gubin210518-alt/busrk-2026-demoday/docs/photos/prototype.jpg

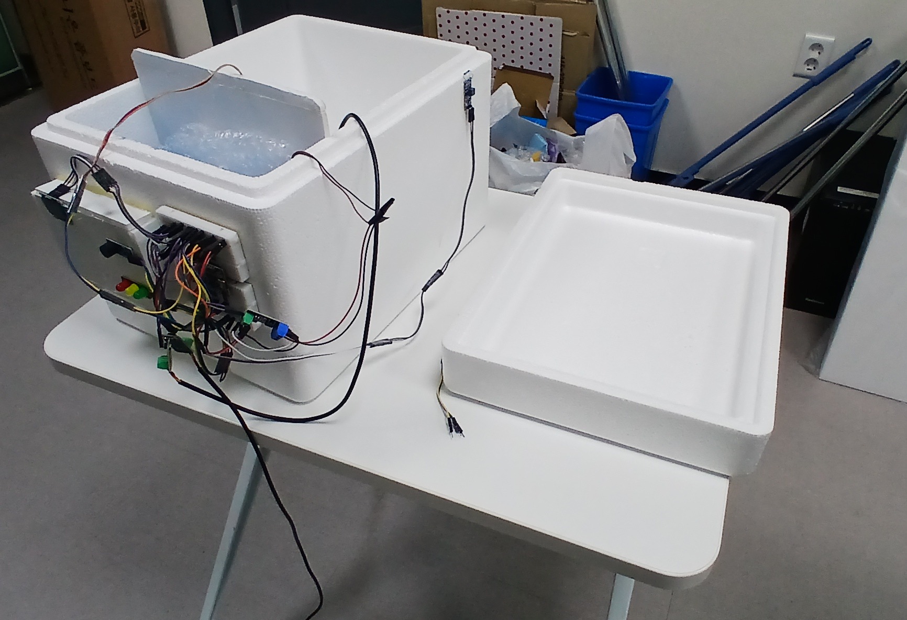
docs/photos/prototype.jpg
