gubin210518-alt/busrk-2026-demoday/README.md

# 부스럭 · 식품의 골든타임을 지키는 예냉박스

TEAM 부스럭(신정고등학교 매니악코더) · 2026 AI동행 프로젝트 피지컬AI 분과 데모데이 예선 출품작

수확한 식품(딸기 등)을 밭에서 바로 식히는 들고 다니는 예냉박스예요. 1시간 안에 다 식을지는 AI가 미리 예측해서 알려줘요.

> **다른 AI가 이어서 작업할 수 있도록 만든 인수인계 문서예요.**
> 지금 실제로 쓰는 결과물과 값만 담았어요. 삭제됐거나 바뀐 옛 내용은 넣지 않았어요.
> 예를 들면 예전 "보냉박스" 버전, 옛 제목 "과일의 골든타임", 옛 Netlify 페이지, 헤더가 나뉜 옛 펌웨어는 빠져 있어요.
> 기준 시점: 2026-11-12

---

## 1. 지금 배포된 주소

| 무엇 | 주소 | 상태 |
|---|---|---|
| 홈페이지 (소개·부착도·배선도·소스코드) | https://busrk-box3d.vercel.app | ✅ 최신. `web/homepage/`와 바이트 단위로 같음 |
| ├ 프로젝트 소개 | https://busrk-box3d.vercel.app/about.html | QR 코드가 가리키는 주소 |
| ├ 부착도·배선도 (3D) | https://busrk-box3d.vercel.app/index.html | |
| └ 소스코드 | https://busrk-box3d.vercel.app/code.html | |
| AI 시뮬레이터 (PC 프로그램) | https://busrk-ai-studio.vercel.app | ⚠️ 저장소가 더 새로움. 2026-11-12에 `ai/`를 고쳐서 `web/simulator/index.html`을 다시 만들었고, 아직 다시 배포하지 않았어요 (8장 1번) |
| (예전) Netlify 홈페이지 | busrk-box3d.netlify.app | ⚠️ **쓰지 말 것.** 크레딧 초과로 갱신이 안 돼서 옛 내용 그대로예요 |
| 발표 슬라이드 원본 | Claude 슬라이드 아티팩트(비공개): https://claude.ai/artifact/AVxc4exyfApQJM1FXrBYHW | 저장소에는 `presentation/`에 사본이 있어요 |

**Vercel 정보**
- 팀: `yeon-38b6` (Hobby)
- 프로젝트: `busrk-box3d`(홈페이지), `busrk-ai-studio`(시뮬레이터)
- GitHub와 연결되어 있지 않아요. 이 저장소에 push해도 자동 배포는 안 돼요. 배포는 Vercel에 파일을 직접 올리는 방식으로 했어요.

---

## 2. 폴더 구조

```
web/homepage/        홈페이지 배포본 그대로 (about.html, index.html, code.html, app.js, wire.js, style.css, favicon.ico, code/*.ino)
web/simulator/       AI 시뮬레이터 배포본 (HTML 한 파일, 외부 라이브러리 없음)
android/             안드로이드 앱 "부스럭 예냉박스" (Android Studio로 이 폴더를 열기, 사용법은 android/README.md)
firmware/            ESP32 아두이노 코드. 각 파일이 혼자 동작하는 단일 파일이에요. 폴더 이름 = 파일 이름이라 IDE에서 바로 열려요.
  precool_ai/        실사용 (목표 1℃, 제한 60분)
  precool_ai_demo/   대회 시연용 (목표 15℃, 제한 10분). precool_ai와 DEMO_MODE 한 줄만 달라요
  precool_ai_ble/    블루투스판: 안드로이드 앱 원격 확인 + 뚜껑·팬 보정. 시연용으로 쓰려면 DEMO_MODE를 true로
  parts_check/       부품 점검
  loop_test/         반복 동작 시험
  fan_test/          팬 단독 시험
ai/                  시뮬레이터 소스 (core.js = AI·시뮬레이션 코어, app_template.html = 화면, default_model.json = 기본 모델)
  build.py           python3 ai/build.py → web/simulator/index.html 생성 (지금 배포본과 바이트 단위로 같게 나옴)
docs/
  AI_기술설명.md      AI 기술·구현 상세 설명 (가장 자세한 문서)
  대회장_실행안내.txt   대회장에서 실행하는 순서
  실측실험_절차.md      실측 실험 순서, 몇 번 해야 하는지, 성공 기준 판정 방법, AI 재학습 순서
  photos/prototype.jpg 시제품 사진
presentation/
  deck.json, slides/  데모데이 발표 슬라이드 원본 사본 (19장)
  발표대본.pdf / .md   슬라이드 발표자 노트를 모은 대본
assets/
  favicon/            쿠키 아이콘 (홈페이지 favicon)
  qr/                 홈페이지·시뮬레이터 QR 코드 (가운데 쿠키 아이콘), make_qr.py
```

`firmware/*`와 `web/homepage/code/*.ino`는 같은 파일이에요. 시연용(`precool_ai_demo`)은 홈페이지에서 따로 파일로 두지 않고, `code.html`이 `precool_ai.ino`의 DEMO_MODE 줄을 바꿔서 내려받게 해요.

---

## 3. 하드웨어

### 3-1. 상자 구조
- 스티로폼 상자를 **폼보드 칸막이**로 나눠서 **냉기실**(아이스팩)과 **식품칸**(딸기)으로 써요.
- 칸막이에서 **냉기실 쪽 면(식품칸과 맞닿는 면)은 뽁뽁이(에어캡)로 단열**해요. 창 부분은 뚫려 있어요.
- 칸막이 창에는 **SG90 서보로 여닫는 폼보드 댐퍼**와 **5V 쿨링팬**을 달아요. 팬은 냉기실의 찬 공기를 식품칸으로 보내요.
- **DS18B20 온도센서 2개**를 식품칸 공기와 냉기실 공기에 하나씩 둬요. 딸기에 직접 닿게 하지 않아요.
- ESP32와 표시부(OLED·신호등 LED·부저)는 상자 옆면 전장 케이스에, 리드스위치와 자석은 뚜껑에 달아요.
- 3D 부착도(three.js)는 홈페이지 `index.html`/`app.js`에 있어요. 상자 크기는 40×28×26cm로 가정했어요.

### 3-2. 부품

| 부품 | 역할 |
|---|---|
| ESP32 WROOM 보드 (HW-394, USB-C, 30핀) | 센서 읽기, 예측, 팬·댐퍼 제어, 기록 |
| DS18B20 방수 온도센서 ×2 | 식품칸·냉기실 공기 온도 |
| SG90 서보 + 폼보드 댐퍼 | 냉기실 창 여닫기 |
| 5V 쿨링팬 + MOSFET 모듈 (+ 1N5819 다이오드) | 찬 공기를 식품칸으로 순환 |
| OLED 0.96" (SSD1306, I2C 0x3C) · 신호등 LED 모듈 · 액티브 부저 모듈 | 온도, 남은 시간, 경고 표시 |
| 리드스위치 모듈 + 자석 | 뚜껑 열림 감지 |
| 스티로폼 상자 · 아이스팩 | 본체와 냉기 공급 |
| 폼보드 칸막이 · 뽁뽁이(에어캡) | 냉기실과 식품칸 분리, 맞닿는 면 단열 |
| 탐침형 디지털 온도계 | 센서 보정, ±1℃ 검증 |

재료 예산은 10만 원이고, 신청 목록 합계는 배송비를 빼고 70,300원이에요.

### 3-3. 핀 연결 (보드에 인쇄된 이름)

| 핀 | 연결 |
|---|---|
| D4 | DS18B20 ×2 DATA (4.7kΩ로 3.3V에 풀업, 저항은 1개) |
| D18 | 서보 신호 (서보 전원 5V) |
| D19 | MOSFET 모듈 PWM (팬 전원 5V) |
| D21 / D22 | OLED SDA / SCL |
| D27 | 리드스위치 DO (3.3V 전원) |
| D26 / D33 / D32 | LED 빨강 / 노랑 / 초록 |
| D25 | 부저 I/O |

- 전원은 3V3를 가운데 왼쪽 + 줄(3.3V 줄)로, VIN을 가운데 오른쪽 + 줄(5V 줄)로 옮겨 써요.
- 배선 순서는 홈페이지 배선도 단계별 버튼에 나와 있어요.
- MOSFET 모듈은 판매 페이지 기준 최소 6V라서, 5V에서는 팬이 약하게 돌 수 있어요.

---

## 4. 펌웨어 동작 (`firmware/precool_ai/precool_ai.ino`)

**설정값**

| 설정 | 값 |
|---|---|
| 목표 온도 `TARGET_C` | 1.0℃ (시연 15℃) |
| 제한 시간 `DEADLINE_MIN` | 60분 (시연 10분) |
| 다시 식히기 시작 | 목표 + 0.5℃ 넘을 때 |
| 얼림 방지 | 식품칸 0℃ 아래면 팬 정지 |
| 예측용 기록·PC 전송 간격 `HIST_MS` | 10초 (시연 5초) |
| 보드 기록 `log.csv` (LittleFS) | 30초마다 |
| 뚜껑 열림 부저 | 30초 넘게 열려 있으면 |
| 댐퍼 각도 | 닫힘 0°, 열림 90° |
| 리드스위치·부저 활성 레벨 | LOW (반대 모듈이면 HIGH로 변경) |
| 센서 주소 | 비워 두면 찾은 순서대로 0번=식품칸, 1번=냉기실 |

**동작 규칙**
- 전원을 켠 순간을 "수확 후 0분"으로 봐요.
- 넣자마자 댐퍼를 열고 팬을 켜요.
- 뚜껑이 열리면 팬을 멈춰요.
- 센서 오류일 때는 "측정 불가"로 표시하고 팬을 멈춰요.

**표시**

| 상태 | 신호등 | 부저 |
|---|---|---|
| 목표 도달 | 초록 | 없음 |
| 식히는 중, 1시간 안에 될 것 같음 | 노랑 | 없음 |
| 1시간 안에 어렵다고 예측됨 | 빨강 | 10초마다 짧게 |
| 1시간이 이미 지남 | 빨강 | 2초마다 |

OLED에는 `ETA 12m AI`처럼 남은 시간과 예측 방법(AI/N)을 보여 줘요. 시연 모드에서는 `DEMO15/10m`이 함께 나와요.

**예측 순서**: AI → (계산 못 하면) 뉴턴 냉각 → (냉기실 센서 오류면) 직선 추세. 처음 2분 동안은 기울기를 아직 구하지 못해서 뉴턴으로 계산해요.

**시리얼 (115200)**
- 데이터 줄: `D,분,식품칸,냉기실,뚜껑열림,팬,상태,뉴턴ETA,AI_ETA` (ETA 값은 -1 = 모름, -2 = 못 닿음)
- 설정 줄: `CFG,목표,제한,시연여부` (시작할 때 보냄)
- 명령: `r` 새 딸기(시간 0부터) · `m` 모델 정보 · `d` 기록 출력 · `x` 기록 삭제 · `a` 센서 주소

**빌드 환경**
- 보드 매니저: esp32 (Espressif) → 보드 **ESP32 Dev Module**
- 라이브러리: OneWire, DallasTemperature, ESP32Servo, Adafruit SSD1306, Adafruit GFX Library (의존 라이브러리 함께 설치)
- `Wire`, `LittleFS`는 보드 패키지에 기본으로 들어 있어요.
- `precool_ai`, `precool_ai_demo`, `parts_check`는 arduino-esp32로 컴파일 성공을 확인했어요.
- `precool_ai_ble`는 실제 arduino-esp32로는 아직 컴파일해 보지 못했어요. (가짜 부품 라이브러리로 PC에서 전체 컴파일·동작 시험만 통과) 블루투스 코드가 커서 **[도구] → Partition Scheme → "Huge APP (3MB No OTA/1MB SPIFFS)"**로 바꿔야 해요. 추가 라이브러리는 없어요(BLE는 보드 패키지에 들어 있음).

**블루투스판(`precool_ai_ble`)에서 달라진 것**
- 2초마다 블루투스로 상태 20바이트를 보내요. 형식은 `android/README.md` 5장.
- 뚜껑·팬 보정: 최근 2분 안에 뚜껑이 열렸거나 팬이 꺼졌으면 직전 AI 예측을 유지하며 줄여요. OLED에 `AI~`, 앱에 "직전 예측 유지"로 표시돼요.
- `BLE_PIN` 6자리: 앱에서 "새 딸기 시작"을 할 때 필요해요. `000000`이면 원격 명령이 꺼져요(보기만 가능). 5번 틀리면 1분 잠금.
- 블루투스로는 `h`(최근 10분 기록)와 `r`+PIN(새 딸기)만 받아요. 기록 삭제는 USB 시리얼로만 돼요.
- 시리얼 `D,` 줄 형식은 그대로라 AI 시뮬레이터와 계속 같이 쓸 수 있어요.

---

## 5. AI 요약 (자세한 내용은 `docs/AI_기술설명.md`)

- **모델**: 특징 4개 `[b−c, c, (b−b_2분전)/2, (c−c_2분전)/2]`를 표준화(z-score)한 뒤, **릿지 회귀(λ=1)**로 2분 뒤 Δb·Δc를 예측해요. b는 식품칸, c는 냉기실 온도예요. 정규방정식은 가우스 소거(부분 피벗)로 풀어요.
- **목표 도달 시간**: 2분 예측을 반복하는 자기회귀 rollout으로 구해요.
  - 최대 90회(180분)까지 반복해요.
  - Δb̂ > −0.005이면 "못 닿음"(−2)으로 처리해요.
  - 목표를 넘는 구간 안에서는 선형 보간해요.
- **비교 기준**:
  - 뉴턴 냉각: 최근 10분의 ln(b − 냉기평균)을 선형 회귀
  - 직선 추세
- **평가**:
  - 실험 단위로 나눠서 5개 중 1개를 시험용으로 써요.
  - 남은 시간 오차는 MAE로 재요. "못 닿음"으로 잘못 예측하면 180분 벌점을 줘요.
- **학습 숫자 18개** (평균 4, 표준편차 4, 가중치 5×2)가 펌웨어의 "학습 모델 (model.h)" 블록에 들어 있어요. 시뮬레이터 "펌웨어로 보내기" 탭에서 새 model.h를 만들어 이 블록을 바꿔 넣어요.
- **현재 모델은 실측이 아니에요.**
  - 3노드 열 모델 시뮬레이션 60회, 학습 표본 31,020개로 사전 학습했어요.
  - 시뮬레이션 계수는 가정값이에요.
  - 시뮬레이션 기준 시험 오차는 AI 7.4분, 직선 15.1분, 뉴턴 45.1분이에요. 다른 가상 실험 묶음으로 재면 AI 7~10분 사이로 흔들려서 **"약 7~10분"**이라고 말하는 게 정확해요. 실제 상자 성능이 아니에요.
- **뚜껑·팬 보정** (2026-11-12 추가, 블루투스판 펌웨어와 시뮬레이터): 뚜껑 직후 예측 오차 70~98분 → 7~15분.
- **평가 보완** (시뮬레이터): 실험이 2~4개면 "한 개씩 빼기 검증", λ 칸이 비면 기본값 1, model.h에 `#pragma once`를 넣지 않아 .ino에 그대로 붙여도 경고 없음.
- **필요한 실측 실험 수**: 가상 실험으로 보면 최소 10회, 권장 15회 이상 (`docs/실측실험_절차.md`).
- **검증한 것**:
  - C와 JS 예측 일치: 무작위 2,000건, 차이 0
  - 펌웨어 보간 일치: 241단계, 불일치 0
  - ESP32 컴파일 성공
- **학습 데이터**: 실측 기록은 아직 없어요. 사용자는 실측값을 줄 수 없다고 했어요.
- **품질 판정은 하지 않아요.** 예측은 참고 표시이고, 출하 판단은 사람이 해요.

---

## 6. 성공 기준

| 항목 | 기준 |
|---|---|
| 냉각 성능 | 실온 딸기를 넣고 1시간 기록해서, 목표 1℃에 닿는지와 몇 분 걸리는지 확인 |
| 미리 경고 | 1시간 안에 못 식는 회차를 10회 중 8회 이상 미리 경고 |
| 헛경고 | 10회 중 2회 이하 |
| 측정 정확도 | 기준 온도계 대비 ±1℃ 이내 |
| AI 예측 | 도달 시간 예측 오차가 직선 추세·뉴턴보다 작을 것, 3회 이상 반복 확인 |

---

## 7. 근거 자료와 방향

- 근거 자료:
  - 캐나다 온타리오 농식품부(OMAFRA): 딸기는 수확 후 1시간 안에 예냉하고 0℃ 가까이 유지
  - Mitchell 외(1996): 25℃에서 냉각을 2·4·6·8시간 늦추면 상품성이 20·37·50·70% 감소
  - 목표 1℃는 과육 목표 온도 34°F를 따른 값이에요.
- 대상: 큰 예냉 설비를 갖추기 어려운 작은 딸기 농가, 직거래·로컬푸드 출하 농가
- 차별점: 팬으로 찬 공기를 돌리는 원리 자체는 새롭지 않아요. 다른 점은 들고 다니는 크기에 **식히기·기록·예측**을 한 박스에 묶은 것이에요.
- 안전·윤리:
  - 품질 판정 없이 참고 표시만 해요.
  - 센서 고장이면 측정 불가로 표시하고 팬을 정지해요.
  - 0℃ 아래로 내려가면 팬을 꺼요.
  - 개인정보는 모으지 않아요.
  - 빛과 소리로 함께 알려서 휴대폰 없이도 확인할 수 있어요.
- SDGs: 목표 12(식량 손실 감소), 목표 2(작은 농가 소득)

---

## 8. 알려진 불일치 · 남은 일

1. **시뮬레이터를 다시 배포해야 해요.** 2026-11-12에 저장소의 시뮬레이터를 고쳤어요(뚜껑·팬 보정, 한 개씩 빼기 검증, λ 기본값, model.h, 홈페이지·소스코드 링크를 Netlify → Vercel로). `web/simulator/index.html`을 `busrk-ai-studio`에 다시 올려야 배포본에도 반영돼요. 아직 올리지 않았어요.
2. **시뮬레이터에는 favicon이 없어요.** `assets/favicon/favicon.ico`를 함께 배포하면 돼요.
3. **Netlify 사이트는 옛 내용이에요.** 계정 크레딧 초과(결제 관련)로 배포가 계속 거절됐어요. 해결하려면 사용자가 직접 판단해야 해요.
4. **발표 슬라이드는 일부러 수정하지 않았어요.** 사용자가 "PPT에는 적용하지 말라"고 했어요. 그래서 현재 구현과 다른 곳이 있어요.
   - 부착도 슬라이드: Netlify 주소, 부품 번호 목록에 뽁뽁이 단열층(12번)이 없음
   - 작동 흐름·표시 기준 슬라이드: "학습 모델 개발 중/다음 단계"라고 되어 있음
   - 슬라이드 이미지는 아티팩트 안의 `/_blob/…`을 참조해서, 저장소 사본만으로는 그림이 나오지 않아요.
5. **실측 데이터가 없어요.** 실제 상자로 실험을 반복해 기록(안드로이드 앱 "기록" 탭, 시뮬레이터 "실험 기록" 탭, `log.csv`)을 모아야 해요. 그 기록만 골라 다시 학습해야 해요. 순서는 `docs/실측실험_절차.md`.
6. **실제 보드에서 처음부터 끝까지 돌려 본 기록은 이 저장소에 없어요.**
7. **10/26에 제출한 프로젝트 설명서(hwpx/pdf)는 넣지 않았어요.** 그 뒤로 제목(과일→식품), AI 구현 여부, 주소 등이 바뀌었기 때문이에요. 지금 기준 내용은 이 README와 `web/homepage/about.html`이에요.
8. **블루투스판 펌웨어와 안드로이드 앱은 실제 기기에서 아직 돌려 보지 않았어요.** 작업 환경에서 ESP32·안드로이드 빌드 도구를 받을 수 없었어요. 계산·통신 형식은 PC에서 검증했어요(`docs/AI_기술설명.md` 6장). 처음 빌드할 때 오류가 나면 고쳐야 해요.
9. **홈페이지 소스코드 페이지에는 블루투스판이 없어요.** `web/homepage/code/`에 넣으려면 `code.html` 목록도 같이 고쳐야 해요.

---

## 9. 이어서 작업할 때 참고할 것

- **이 프로젝트 사용자와 일할 때 지킬 것** (사용자: 코딩 초보, 바이브코딩)
  - 답은 항상 한국어로 해요.
  - 구체적인 지시는 빠짐없이 적용해요.
  - 모르면 솔직히 모른다고 해요.
  - 의견이 필요하면 물어봐요.
  - 보안은 꼼꼼히 봐요.
  - 결제 관련 일은 반드시 먼저 알려요.
  - 다른 AI의 API 키를 쓸 때는 쓰겠다고 먼저 말해요.
  - 학습 관련 값은 3번 이상 검토해요.
- 홈페이지 `code.html`은 코드를 `code/*.ino`에서 fetch로 불러와 보여 줘요. 펌웨어를 바꾸면 `web/homepage/code/`와 `firmware/`를 같이 바꿔요.
- 화면 문구는 존댓말 "~해요"체를 써요. 용어는 "식품칸 / 냉기실"이에요. 예전 용어 "딸기칸"은 쓰지 않아요.
- Vercel API로 파일을 인라인(utf-8) 업로드하면 일부 희귀 한글(삑·껐·댔·뗐·땜 등)이 깨진 적이 있어요. 배포 뒤에는 `curl`로 받아 원본과 sha1을 비교해 확인하세요.
