gubin210518-alt/busrk-2026-demoday/assets/qr/부스럭_AI시뮬레이터_QR.png

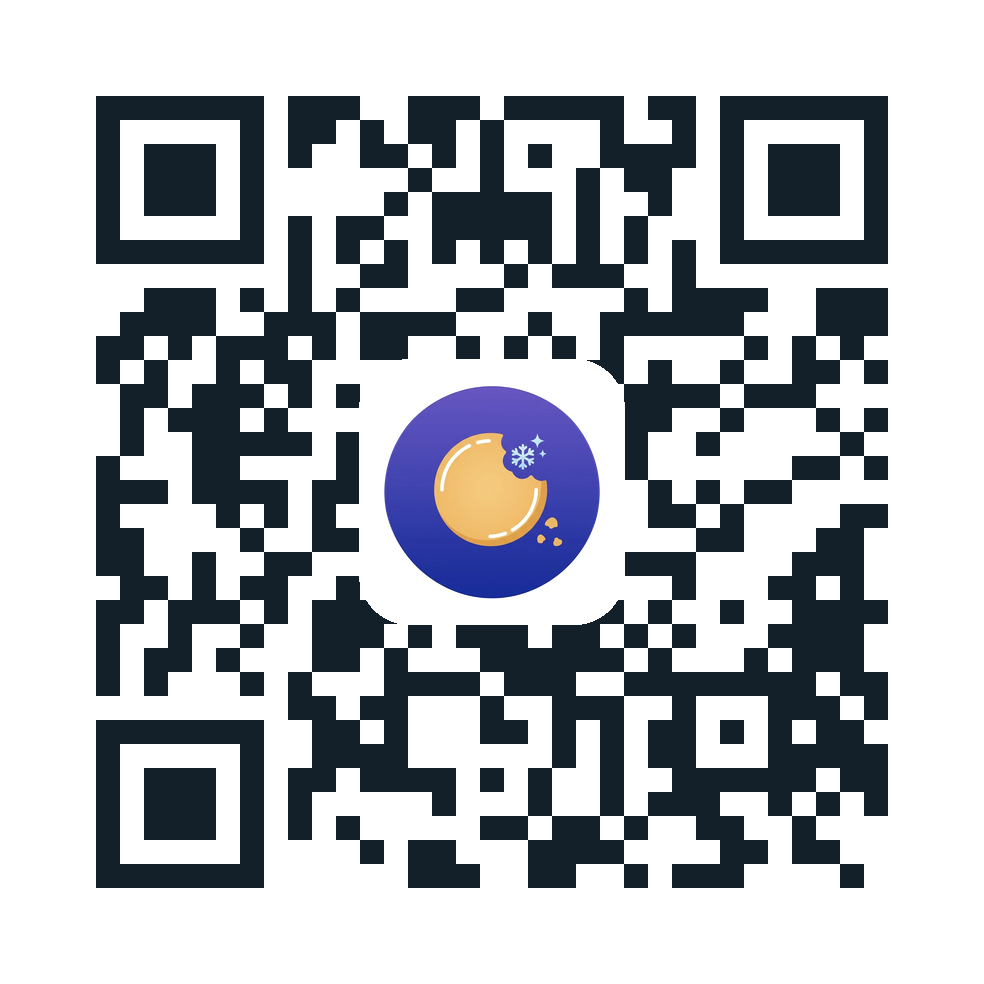
assets/qr/부스럭_AI시뮬레이터_QR.png
