gubin210518-alt/busrk-2026-demoday/assets/qr/부스럭_홈페이지_QR.png

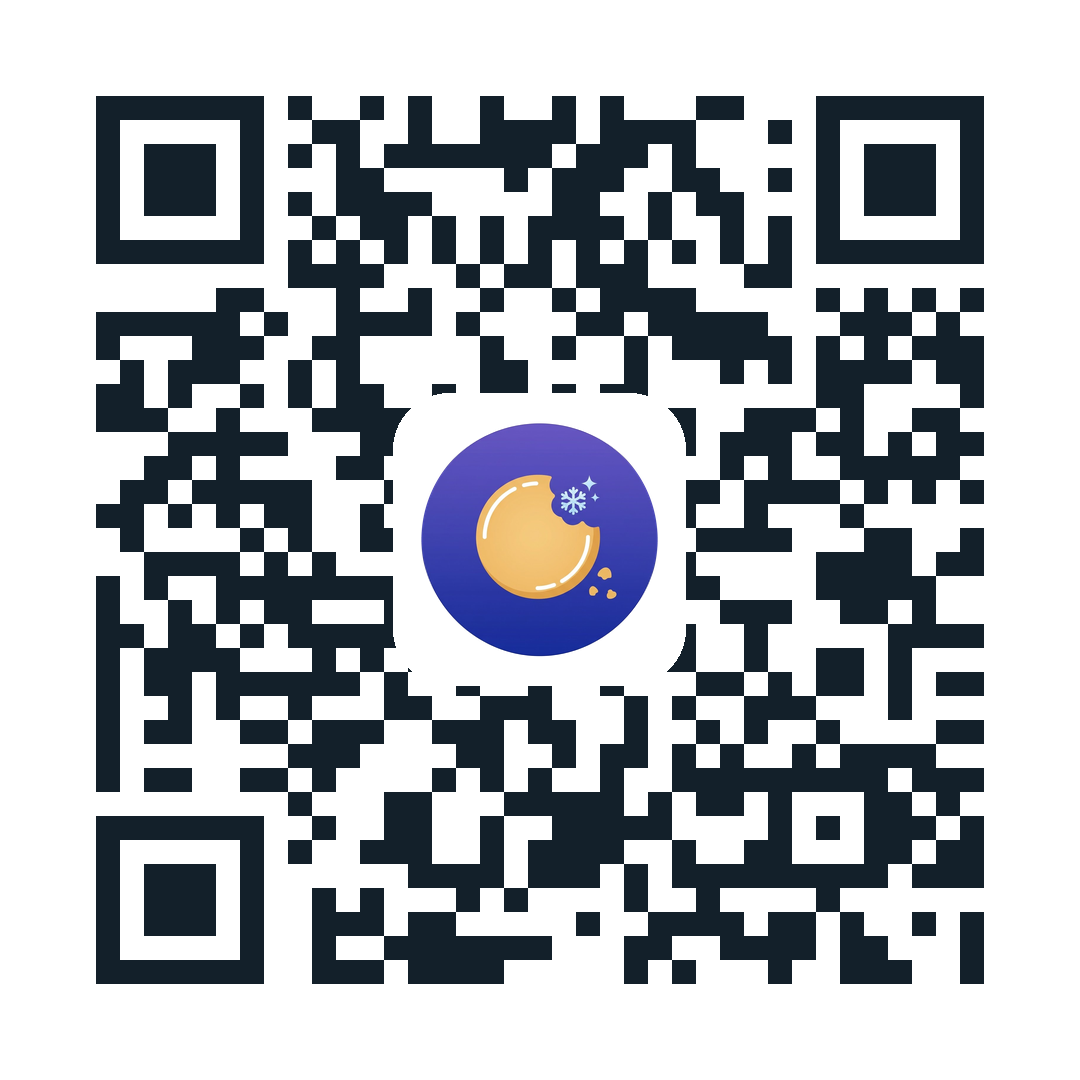
assets/qr/부스럭_홈페이지_QR.png
