gubin210518-alt/busrk-2026-demoday/(commit log)

2026-11-11 예냉박스 현재 결과물 정리 (인수인계용)
    홈페이지·AI 시뮬레이터 배포본, ESP32 펌웨어 5종, 시뮬레이터 소스와 빌드 스크립트,
    AI 기술 설명서, 발표 슬라이드·대본, favicon·QR, 인수인계 README.
    Claude-Session: https://claude.ai/code/session_012PmCwxPN56CB4iRTUjwUSg
2026-11-11 블루투스 원격 확인 앱 + AI 구체화
    - android/: 안드로이드 앱 "부스럭 예냉박스" (Kotlin + Jetpack Compose)
    BLE 연결·자동 재연결, 상태·남은 시간·도착 예상 시각, 온도 그래프,
    백그라운드 알림 6종, 회차별 CSV 기록·조건 메모·공유, PIN 원격 명령
    - firmware/precool_ai_ble/: 블루투스판 펌웨어 (기존 펌웨어는 그대로)
    상태 20바이트 전송, PIN·잠금이 있는 원격 명령, 최근 10분 기록 전송
    - AI 뚜껑·팬 보정: 최근 2분 안에 뚜껑 열림/팬 꺼짐이면 직전 AI 예측 유지
    (가상 실험 기준 뚜껑 직후 오차 70~98분 → 7~15분, 펌웨어·PC 계산 일치)
    - 시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
